KarpelesLab/ledger_implant_detector/hardware/detector/fab/drc_report.txt

** Drc report for implant_detector.kicad_pcb **
** Created on 2026-10-18T11:38:48 **
** Report includes: Errors, Warnings, Exclusions **

** Found 5 DRC violations **
[starved_thermal]: Thermal relief connection to zone incomplete (layer F.Cu; zone min spoke count 2; actual 1)
    Local override; error
    @(220.0000 mm, 80.0000 mm): Zone 'GND_top' [GND] on F.Cu, priority 0
    @(132.4375 mm, 100.2500 mm): Pad 4 [GND] of U1 on F.Cu
[starved_thermal]: Thermal relief connection to zone incomplete (layer F.Cu; zone min spoke count 2; actual 1)
    Local override; error
    @(220.0000 mm, 80.0000 mm): Zone 'GND_top' [GND] on F.Cu, priority 0
    @(215.1700 mm, 99.6800 mm): PTH pad SH [GND] of J1
[starved_thermal]: Thermal relief connection to zone incomplete (layer F.Cu; zone min spoke count 2; actual 1)
    Local override; error
    @(220.0000 mm, 80.0000 mm): Zone 'GND_top' [GND] on F.Cu, priority 0
    @(208.0000 mm, 92.2250 mm): Pad 2 [GND] of C11 on F.Cu
[silk_edge_clearance]: Silkscreen clipped by board edge
    Rule: board setup constraints silk; warning
    @(222.0000 mm, 82.0000 mm): Segment on Edge.Cuts
    @(220.3000 mm, 99.3000 mm): Segment of J1 on F.Silkscreen
[silk_edge_clearance]: Silkscreen clipped by board edge
    Rule: board setup constraints silk; warning
    @(222.0000 mm, 82.0000 mm): Segment on Edge.Cuts
    @(220.3000 mm, 108.7000 mm): Segment of J1 on F.Silkscreen

** Found 0 unconnected pads **

** Found 0 Footprint errors **

** Ignored checks **
    - Footprint has no courtyard defined
    - Track endpoint not centered on via
    - Tuning profile track geometries
    - Footprint doesn't match symbol's footprint filters
    - Footprint component type doesn't match footprint pads

** End of Report **
