KarpelesLab/ledger_implant_detector/hardware/fixtures/tem_plate/fab/drc_report.txt

** Drc report for tem_plate.kicad_pcb **
** Created on 2026-10-26T17:50:04 **
** Report includes: Errors, Warnings **

** Found 0 DRC violations **

** Found 0 unconnected pads **

** Found 0 Footprint errors **

** Ignored checks **
    - Footprint has no courtyard defined
    - Track endpoint not centered on via
    - Tuning profile track geometries
    - Footprint doesn't match symbol's footprint filters
    - Isolated copper fill
    - Footprint component type doesn't match footprint pads

** End of Report **
