KarpelesLab/ledger_implant_detector/data/rf/2026-10-18/img/tamp_antenna_feed.png

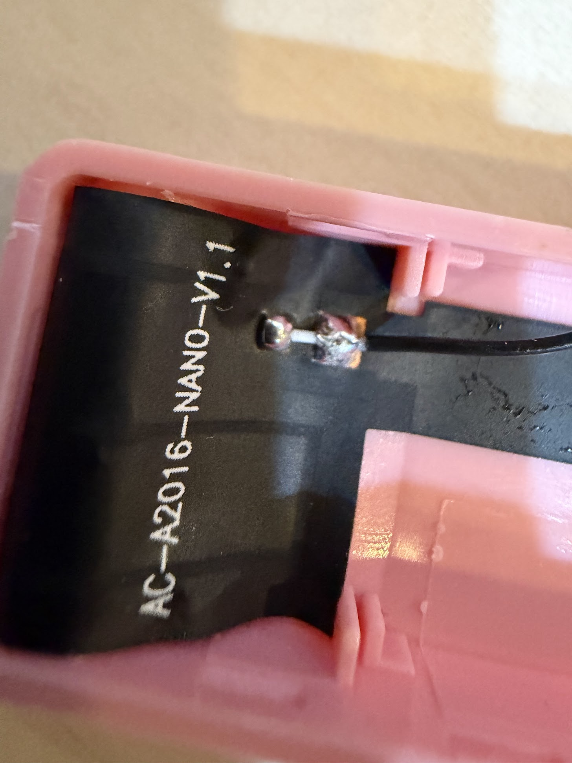
data/rf/2026-10-18/img/tamp_antenna_feed.png
