KarpelesLab/ledger_implant_detector/docs/img/fixture_carrier_bottom.png

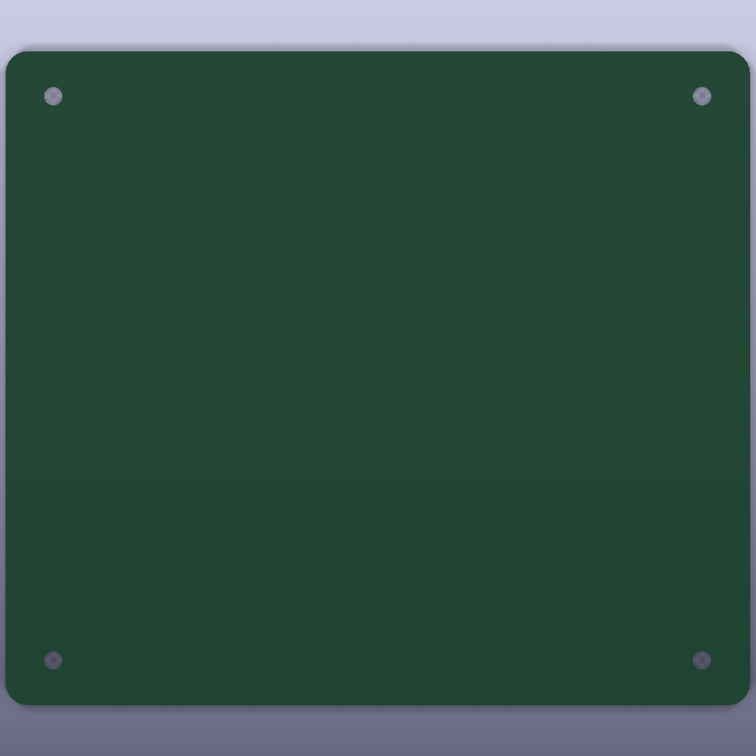
docs/img/fixture_carrier_bottom.png
