KarpelesLab/ledger_implant_detector/docs/img/fixture_slot_bottom.png

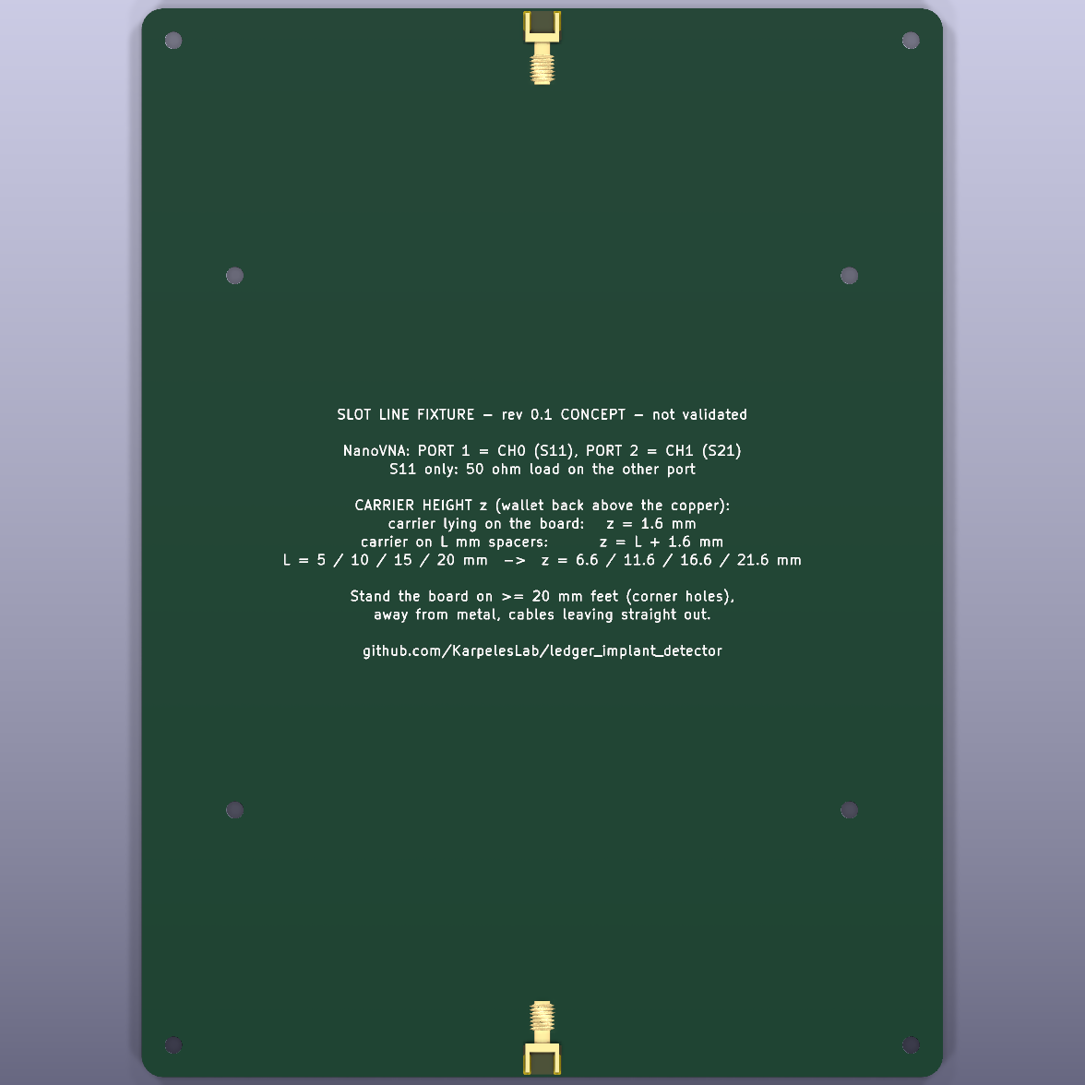
docs/img/fixture_slot_bottom.png
