KarpelesLab/ledger_implant_detector/docs/img/fixture_tem_base_bottom.png

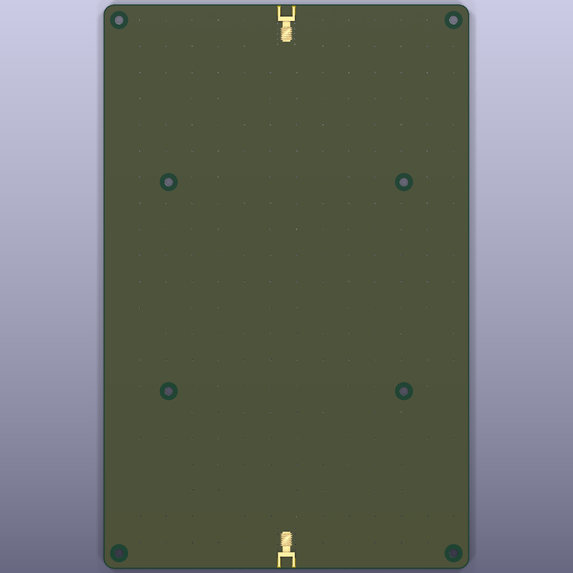
docs/img/fixture_tem_base_bottom.png
