KarpelesLab/ledger_implant_detector/docs/img/fixture_tem_ramp_bottom.png

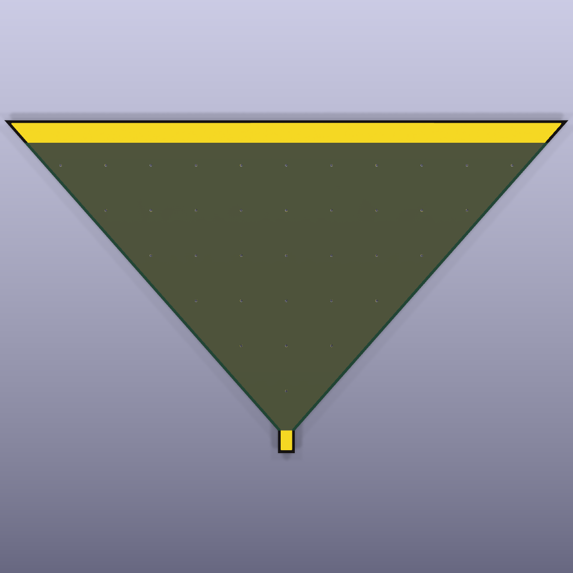
docs/img/fixture_tem_ramp_bottom.png
