KarpelesLab/ledger_implant_detector/hardware/detector/fab/bom.csv

Designator | Value | Footprint | MPN | Manufacturer | LCSC | Qty | DNP
BZ1 | PKLCS1212E4001 | Buzzer_Beeper:Buzzer_Murata_PKLCS1212E | PKLCS1212E4001-R1 | Murata |  | 1
C1-C8 | 33p | Capacitor_SMD:C_0603_1608Metric | GRM1885C1H330FA01D | Murata |  | 8
C9,C10,C13 | 4.7u | Capacitor_SMD:C_0603_1608Metric |  |  |  | 3
C11,C12,C14,C15,C17,C19 | 100n | Capacitor_SMD:C_0603_1608Metric |  |  |  | 6
C16,C18 | 1u | Capacitor_SMD:C_0603_1608Metric |  |  |  | 2
D1 | GREEN | LED_SMD:LED_0603_1608Metric | 19-217/GHC-YR1S2/3T | Everlight |  | 1
D2 | RED | LED_SMD:LED_0603_1608Metric | 19-217/R6C-AL1M2VY/3T | Everlight |  | 1
J1 | USB-C | Connector_USB:USB_C_Receptacle_HRO_TYPE-C-31-M-12 | TYPE-C-31-M-12 | Korean Hroparts Elec | C165948 | 1
J2 | Qwiic | Connector_JST:JST_SH_SM04B-SRSS-TB_1x04-1MP_P1.00mm_Horizontal | SM04B-SRSS-TB(LF)(SN) | JST |  | 1
J4 | SMA | Connector_Coaxial:SMA_Samtec_SMA-J-P-H-ST-EM1_EdgeMount | SMA-J-P-H-ST-EM1 | Samtec |  | 1
L1-L8 | 18u | Inductor_SMD:L_1210_3225Metric | CMH322522-180KL | Bourns |  | 8
R1,R2 | 5.1k | Resistor_SMD:R_0603_1608Metric |  |  |  | 2
R3,R9,R10 | 10k | Resistor_SMD:R_0603_1608Metric |  |  |  | 3
R4,R5 | 1k | Resistor_SMD:R_0603_1608Metric |  |  |  | 2
R6 | 100 | Resistor_SMD:R_0603_1608Metric |  |  |  | 1
R7,R8 | 4.7k | Resistor_SMD:R_0603_1608Metric |  |  |  | 2
R11 | 100k | Resistor_SMD:R_0603_1608Metric |  |  |  | 1
R12 | 33 | Resistor_SMD:R_0603_1608Metric |  |  |  | 1
SW1 | CAL | Button_Switch_SMD:SW_SPST_PTS810 | PTS810 SJM 250 SMTR LFS | C&K |  | 1
SW2 | BOOT | Button_Switch_SMD:SW_SPST_PTS810 | PTS810 SJM 250 SMTR LFS | C&K |  | 1
U1,U2 | FDC2214 | Package_DFN_QFN:WQFN-16-1EP_4x4mm_P0.5mm_EP2.6x2.6mm | FDC2214RGHR | Texas Instruments |  | 2
U3 | STM32F042F6P6 | Package_SO:TSSOP-20_4.4x6.5mm_P0.65mm | STM32F042F6P6 | STMicroelectronics |  | 1
U4 | AP2112K-3.3 | Package_TO_SOT_SMD:SOT-23-5 | AP2112K-3.3TRG1 | Diodes Inc |  | 1
U5 | USBLC6-2SC6 | Package_TO_SOT_SMD:SOT-23-6 | USBLC6-2SC6 | STMicroelectronics |  | 1
Y1 | 40MHz | Oscillator:Oscillator_SMD_Abracon_ASE-4Pin_3.2x2.5mm | ASE-40.000MHZ-LC-T | Abracon |  | 1
