KarpelesLab/ledger_implant_detector/hardware/detector/fab/schematic.pdf

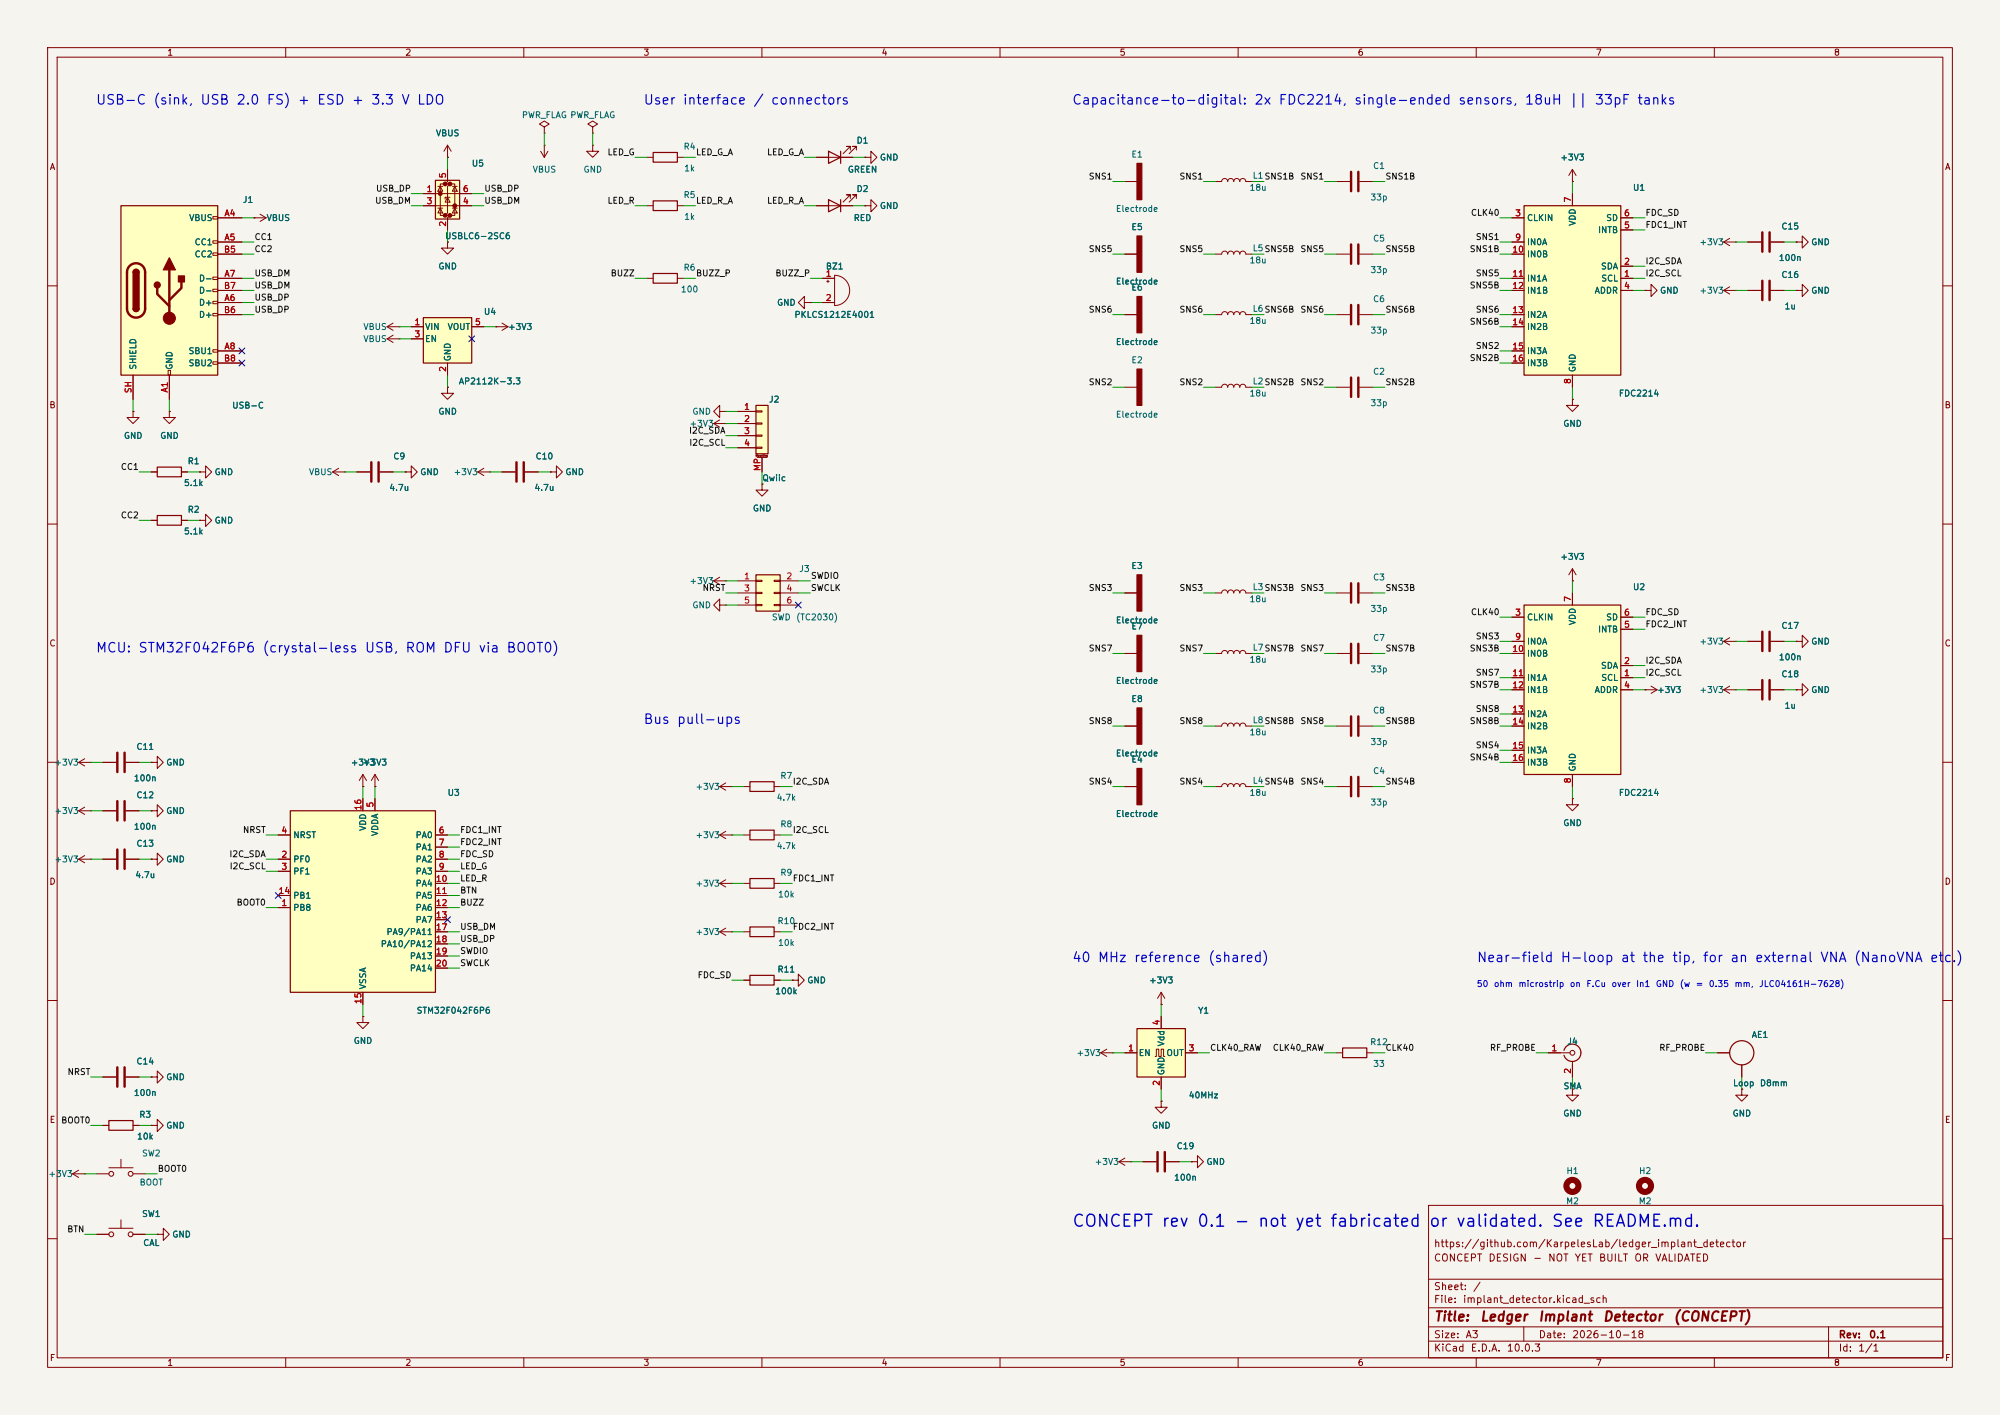
[picture p23: page 1]

USB-C (sink, USB 2.0 FS) + ESD + 3.3 V LDO

MCU: STM32F042F6P6 (crystal-less USB, ROM DFU via BOOT0)

Near-field H-loop at the tip, for an external VNA (NanoVNA etc.)

50 ohm microstrip on F.Cu over In1 GND (w = 0.35 mm, JLC04161H-7628)

https://github.com/KarpelesLab/ledger_implant_detector
CONCEPT DESIGN - NOT YET BUILT OR VALIDATED

Sheet: /
File: implant_detector.kicad_sch
Title: Ledger Implant Detector (CONCEPT)

Size: A3 | Rev: 0.1
KiCad E.D.A. 10.0.3 | Id: 1/1 | F Date: 2026-10-18
