KarpelesLab/ledger_implant_detector/hardware/detector/implant_detector.kicad_pcb

## KiCad design hardware/detector/implant_detector.kicad_pcb (2026-10-18)

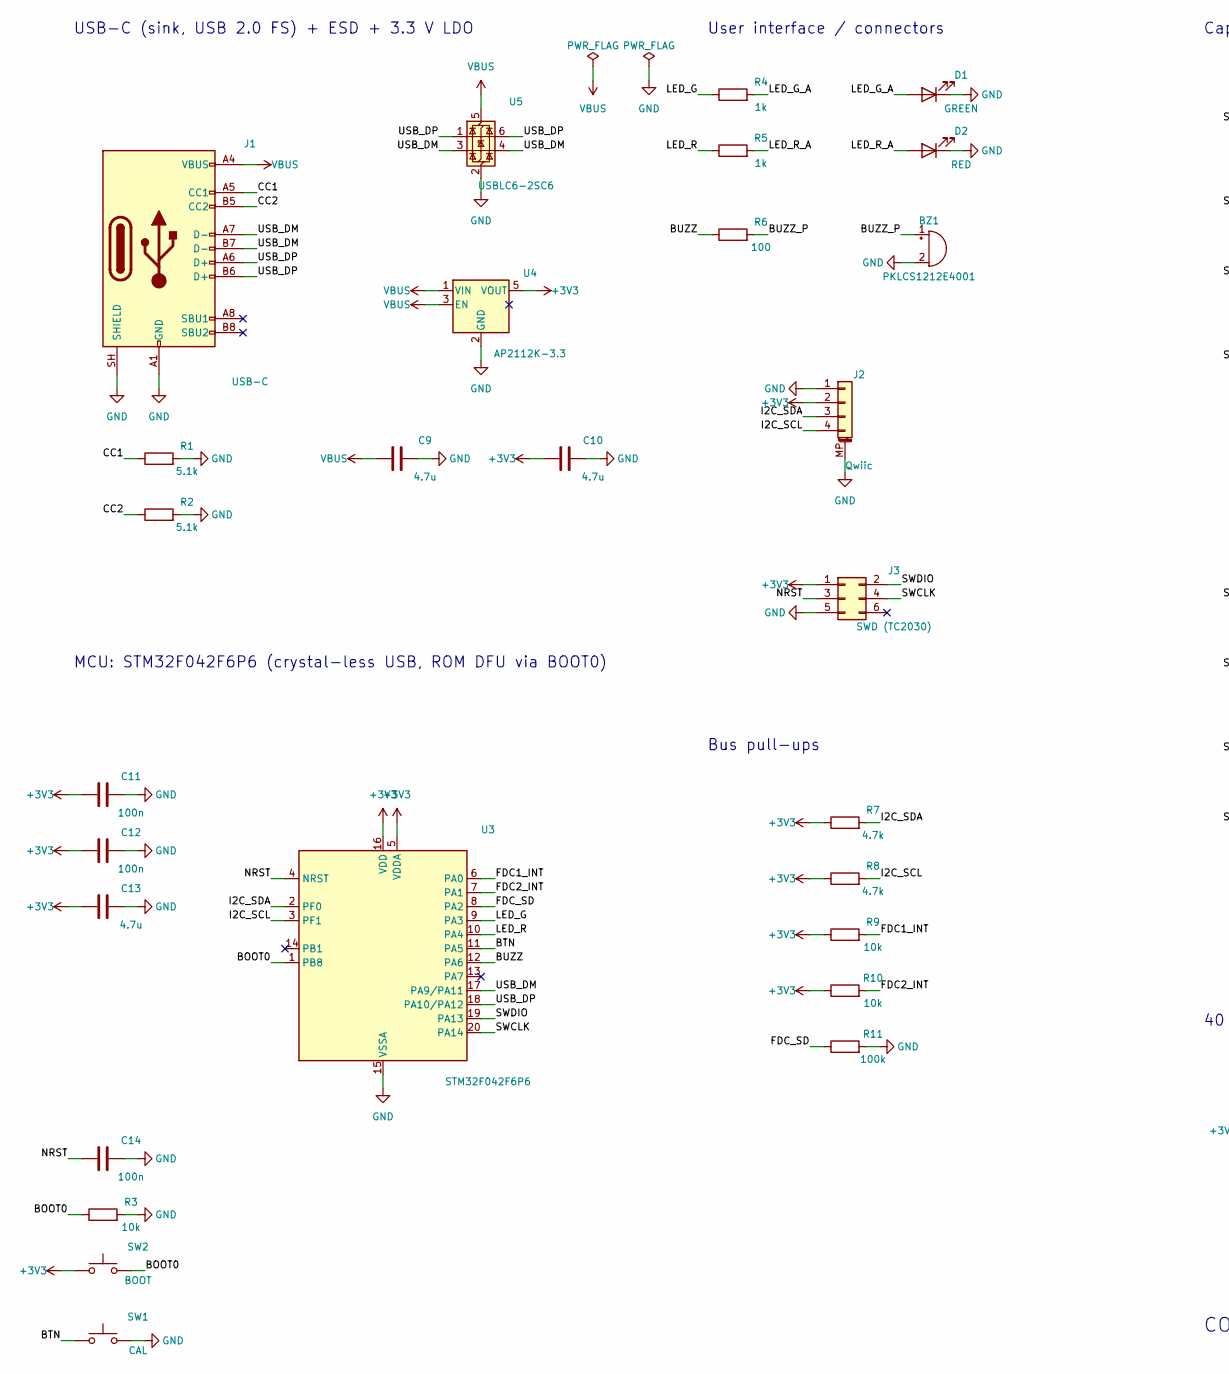
[picture p24: schematic implant_detector.kicad_sch, Ledger Implant Detector (CONCEPT), part in row 1, column 1]

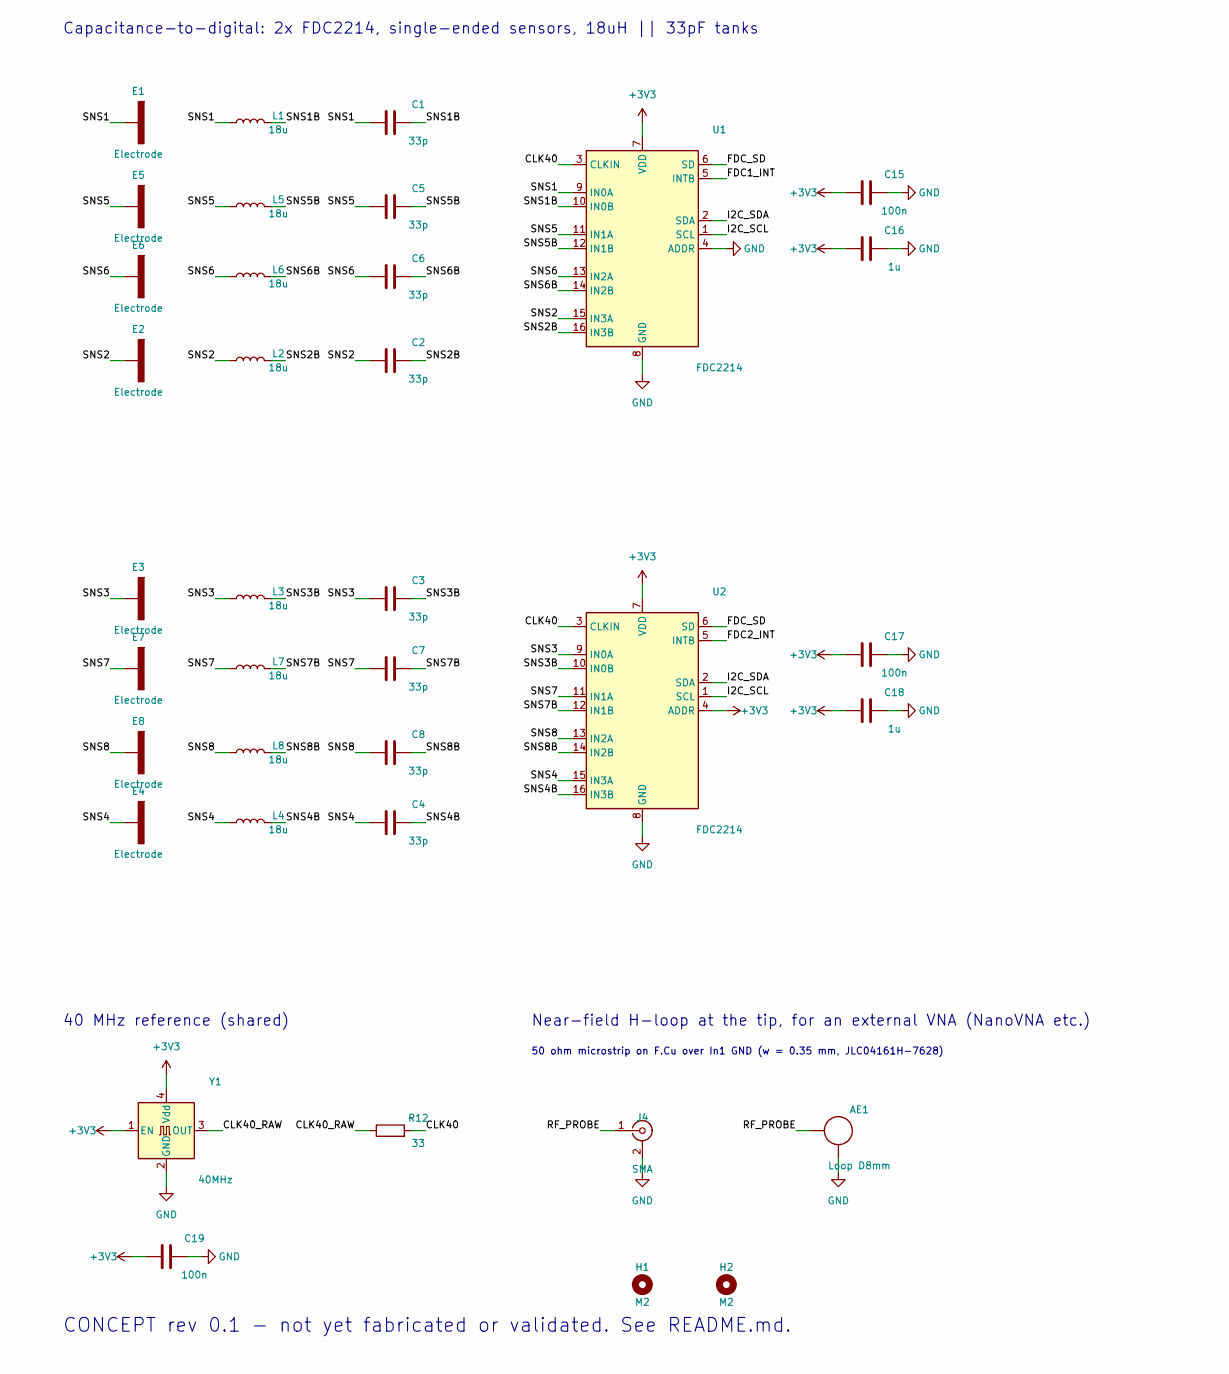
[picture p25: schematic implant_detector.kicad_sch, Ledger Implant Detector (CONCEPT), part in row 1, column 2]

Parts:
AE1: Loop D8mm; NearField_Loop_D8mm
BZ1: PKLCS1212E4001; Buzzer_Murata_PKLCS1212E; MPN PKLCS1212E4001-R1
C1, C2, C3, C4, C5, C6, C7, C8: 33p; C_0603_1608Metric; Tolerance 1%; MPN GRM1885C1H330FA01D
C9, C10, C13: 4.7u; C_0603_1608Metric; Voltage 10V
C11, C12, C14, C15, C17, C19: 100n; C_0603_1608Metric
C16, C18: 1u; C_0603_1608Metric
D1: GREEN; LED_0603_1608Metric; MPN 19-217/GHC-YR1S2/3T
D2: RED; LED_0603_1608Metric; MPN 19-217/R6C-AL1M2VY/3T
E1, E2, E3, E4, E5, E6, E7, E8: Electrode; Electrode_14x14mm
H1, H2: M2; MountingHole_2.2mm_M2
J1: USB-C; USB_C_Receptacle_HRO_TYPE-C-31-M-12; MPN TYPE-C-31-M-12; LCSC C165948
J2: Qwiic; JST_SH_SM04B-SRSS-TB_1x04-1MP_P1.00mm_Horizontal; MPN SM04B-SRSS-TB(LF)(SN)
J3: SWD (TC2030); Tag-Connect_TC2030-IDC-NL_2x03_P1.27mm_Vertical
J4: SMA; SMA_Samtec_SMA-J-P-H-ST-EM1_EdgeMount; MPN SMA-J-P-H-ST-EM1
L1, L2, L3, L4, L5, L6, L7, L8: 18u; L_1210_3225Metric; MPN CMH322522-180KL
R1, R2: 5.1k; R_0603_1608Metric
R3, R9, R10: 10k; R_0603_1608Metric
R4, R5: 1k; R_0603_1608Metric
R6: 100; R_0603_1608Metric
R7, R8: 4.7k; R_0603_1608Metric
R11: 100k; R_0603_1608Metric
R12: 33; R_0603_1608Metric
SW1: CAL; SW_SPST_PTS810; MPN PTS810 SJM 250 SMTR LFS
SW2: BOOT; SW_SPST_PTS810; MPN PTS810 SJM 250 SMTR LFS
U1, U2: FDC2214; WQFN-16-1EP_4x4mm_P0.5mm_EP2.6x2.6mm; MPN FDC2214RGHR
U3: STM32F042F6P6; TSSOP-20_4.4x6.5mm_P0.65mm; MPN STM32F042F6P6
U4: AP2112K-3.3; SOT-23-5; MPN AP2112K-3.3TRG1
U5: USBLC6-2SC6; SOT-23-6; MPN USBLC6-2SC6
Y1: 40MHz; Oscillator_SMD_Abracon_ASE-4Pin_3.2x2.5mm; MPN ASE-40.000MHZ-LC-T

Connections:
+3V3: C10.1, C11.1, C12.1, C13.1, C15.1, C16.1, C17.1, C18.1, C19.1, J2.2, J3.1, R7.1, R8.1, R9.1, R10.1, SW2.1, U1.7 (VDD), U2.4 (ADDR), U2.7 (VDD), U3.5 (VDDA), U3.16 (VDD), U4.5 (VOUT), Y1.1 (EN), Y1.4 (Vdd)
/BOOT0: R3.1, SW2.2, U3.1 (PB8)
/BTN: SW1.1, U3.11 (PA5)
/BUZZ: R6.1, U3.12 (PA6)
/BUZZ_P: BZ1.1 (+), R6.2
/CC1: J1.A5 (CC1), R1.1
/CC2: J1.B5 (CC2), R2.1
/CLK40: R12.2, U1.3 (CLKIN), U2.3 (CLKIN)
/CLK40_RAW: R12.1, Y1.3 (OUT)
/FDC1_INT: R9.2, U1.5 (INTB), U3.6 (PA0)
/FDC2_INT: R10.2, U2.5 (INTB), U3.7 (PA1)
/FDC_SD: R11.1, U1.6 (SD), U2.6 (SD), U3.8 (PA2)
/I2C_SCL: J2.4, R8.2, U1.1 (SCL), U2.1 (SCL), U3.3 (PF1)
/I2C_SDA: J2.3, R7.2, U1.2 (SDA), U2.2 (SDA), U3.2 (PF0)
/LED_G: R4.1, U3.9 (PA3)
/LED_G_A: D1.2 (A), R4.2
/LED_R: R5.1, U3.10 (PA4)
/LED_R_A: D2.2 (A), R5.2
/NRST: C14.1, J3.3, U3.4 (NRST)
/RF_PROBE: AE1.1 (FEED), J4.1 (In)
/SNS1: C1.1, E1.1, L1.1, U1.9 (IN0A)
/SNS1B: C1.2, L1.2, U1.10 (IN0B)
/SNS2: C2.1, E2.1, L2.1, U1.15 (IN3A)
/SNS2B: C2.2, L2.2, U1.16 (IN3B)
/SNS3: C3.1, E3.1, L3.1, U2.9 (IN0A)
/SNS3B: C3.2, L3.2, U2.10 (IN0B)
/SNS4: C4.1, E4.1, L4.1, U2.15 (IN3A)
/SNS4B: C4.2, L4.2, U2.16 (IN3B)
/SNS5: C5.1, E5.1, L5.1, U1.11 (IN1A)
/SNS5B: C5.2, L5.2, U1.12 (IN1B)
/SNS6: C6.1, E6.1, L6.1, U1.13 (IN2A)
/SNS6B: C6.2, L6.2, U1.14 (IN2B)
/SNS7: C7.1, E7.1, L7.1, U2.11 (IN1A)
/SNS7B: C7.2, L7.2, U2.12 (IN1B)
/SNS8: C8.1, E8.1, L8.1, U2.13 (IN2A)
/SNS8B: C8.2, L8.2, U2.14 (IN2B)
/SWCLK: J3.4, U3.20 (PA14)
/SWDIO: J3.2, U3.19 (PA13)
/USB_DM: J1.A7 (D-), J1.B7 (D-), U3.17 (PA9/PA11), U5.3 (I/O2), U5.4 (I/O2)
/USB_DP: J1.A6 (D+), J1.B6 (D+), U3.18 (PA10/PA12), U5.1 (I/O1), U5.6 (I/O1)

Notes on the sheet:
USB-C (sink, USB 2.0 FS) + ESD + 3.3 V LDO
MCU: STM32F042F6P6 (crystal-less USB, ROM DFU via BOOT0)
User interface / connectors
Bus pull-ups
40 MHz reference (shared)
Capacitance-to-digital: 2x FDC2214, single-ended sensors, 18uH || 33pF tanks
Near-field H-loop at the tip, for an external VNA (NanoVNA etc.)
50 ohm microstrip on F.Cu over In1 GND (w = 0.35 mm, JLC04161H-7628)
CONCEPT rev 0.1 - not yet fabricated or validated. See README.md.

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
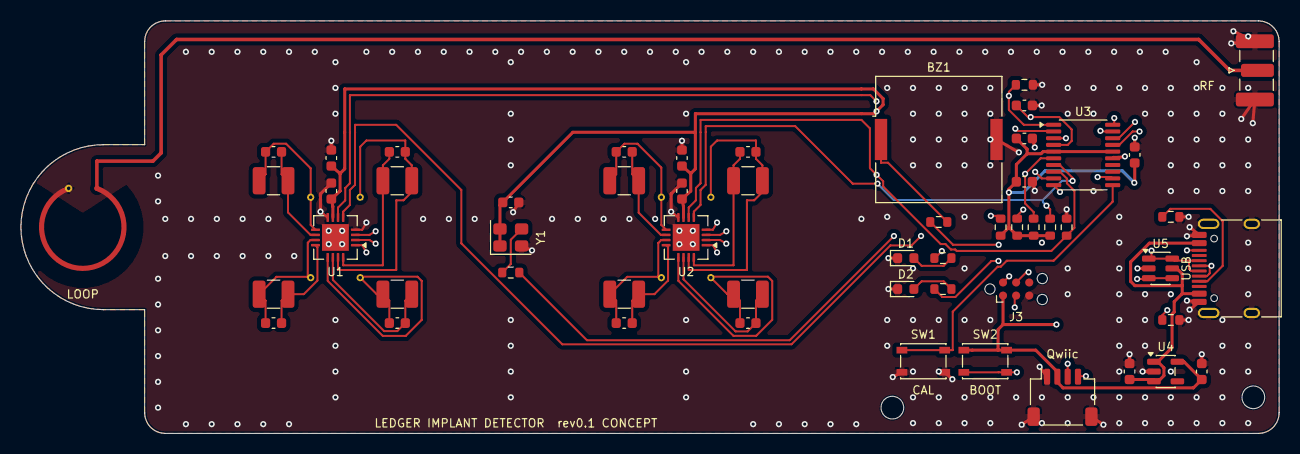
[picture p26: board implant_detector.kicad_pcb from above]

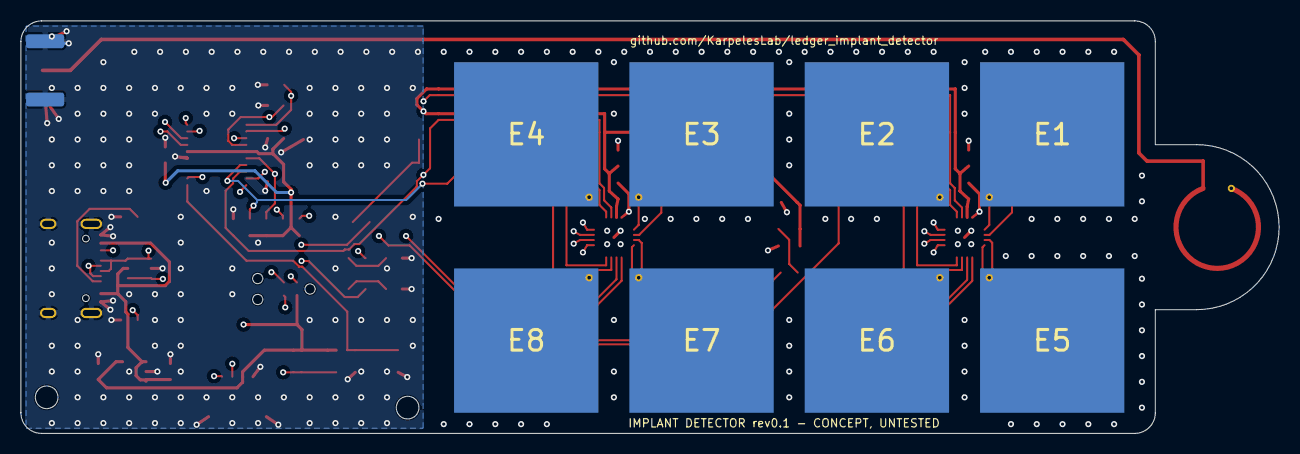
[picture p27: board implant_detector.kicad_pcb from below]

Board: 4 copper layers, 122.0 x 40.0 mm, 65 parts (8 on the bottom side), 42 nets.
