KarpelesLab/ledger_implant_detector/hardware/fixtures/slot/slot.kicad_pcb

## KiCad design hardware/fixtures/slot/slot.kicad_pcb (2026-10-18)

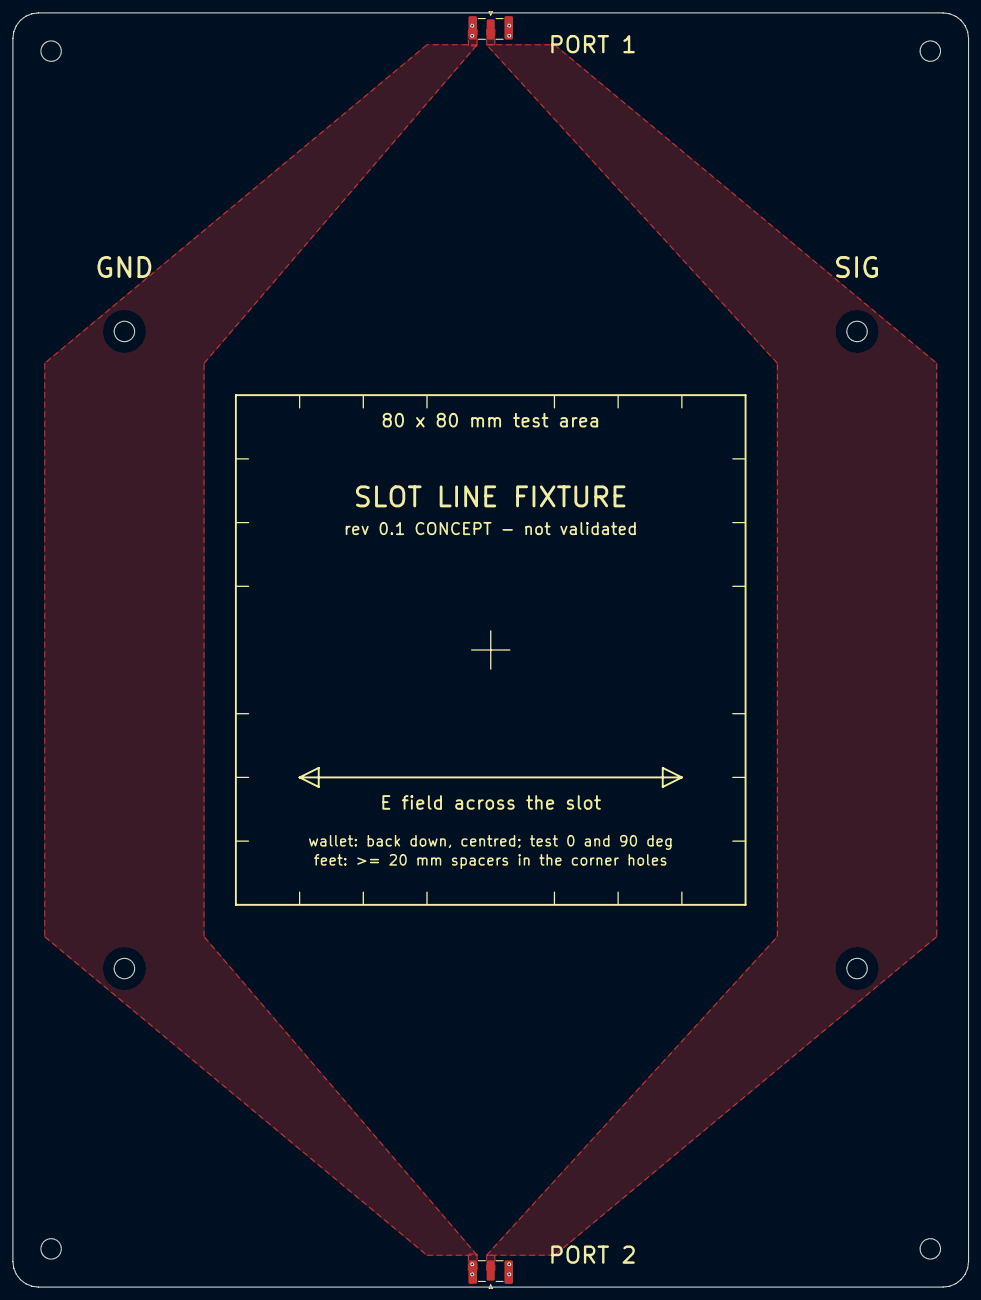
[picture p28: board slot.kicad_pcb from above]

Board: 2 copper layers, 150.0 x 200.0 mm, 10 parts (0 on the bottom side), 2 nets, no tracks yet.

Parts:
H1, H2, H3, H4, H5, H6, H7, H8: MountingHole_3.2mm_M3
J1, J2: SMA edge jack (Samtec SMA-J-P-H-ST-EM1); SMA_Samtec_SMA-J-P-H-ST-EM1_EdgeMount

Connections:
GND: J1.2, J2.2
SIG: J1.1, J2.1
