KarpelesLab/ledger_implant_detector/(commit log)

2026-10-18 Add concept README for capacitive Ledger implant detector
2026-10-18 Add project library and detector schematic (ERC clean)
    FDC2214 symbol derived from KiCad LDC1314 (pin-compatible WQFN-16),
    electrode and near-field loop footprints, schematic generator.
    [implant_detector.kicad_sch]
2026-10-18 Add routed 4-layer detector PCB, fab outputs and renders
    Single board: 8-electrode capacitive head (2x FDC2214), STM32F042 with USB-C
    power + ROM DFU programming, near-field RF loop at the tip with edge SMA.
    Electrodes shrunk to 14x14 mm to open a via channel; head tanks and escapes
    are pre-routed deterministically, rest autorouted with Freerouting 1.9.
    DRC: 0 errors, 0 unconnected, schematic parity OK. ERC: 0 violations.
    Concept / untested, see README.
    [bom.csv, bom_jlc.csv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]
2026-10-18 Add NanoVNA measurement protocol and S11 comparison script
    Defines how to capture reference / mock-implant / copper-control sweeps so the
    data decides the on-board RF front end for rev 0.2 (scalar log detector vs
    gain/phase vs full VNA). analyze_s1p.py compares groups of Touchstone files
    against placement repeatability and prints that verdict.
2026-10-18 Add electrostatic + FDTD simulations of the implant antenna vs. the battery
    Electrostatic model of the detector over a genuine / tampered wallet with the
    antenna sandwiched between shell and battery: copper outside the battery's
    shadow is detectable well above placement errors; copper fully hidden behind
    the battery and floating is not. FDTD model of the RF loop (validated against
    cavity / capacitor / loop inductance); RF results to follow.
2026-10-18 Clarify antenna/battery geometry wording in the simulation write-up
    The antenna is always between the shell and the battery; the distinction that
    matters is how much of it extends beyond the battery's outline.
2026-10-18 Add RF FDTD results: loaded antenna shows an in-band absorption dip plain copper lacks
    Over the feed patch the tampered unit shows a ~0.35 dB, ~100 MHz wide dip at
    ~1.8 GHz that neither the genuine unit nor a plain-copper control of the same
    outline has; copper lying on the battery foil is RF-dead. Simulated .s1p
    files included for comparison with NanoVNA measurements.
2026-10-18 Add NanoVNA capture tool and first RF session on a real implanted Nano X
    tools/nanovna_capture.py drives a NanoVNA-F V2 text shell: OSLT calibration
    steps, 401-point captures from interleaved 201-point scans with averaging,
    retry on the firmware's all-zeros state, and .s1p or .s2p (S11 + S21) output.
    analyze_s1p.py gains --s21 to compare transmission sweeps.
    data/rf/2026-10-18: genuine Nano X vs a real modified unit (custom FPC LTE
    antenna "AC-A2016-NANO-V1.1", photo included). Reflection (S11) with a bare
    coax tip and a 5 mm H loop shows no separation above placement spread.
    Transmission from a ~10 mm H loop to a GSM antenna does: the tampered unit
    re-radiates at ~820-850 MHz, 740-860 MHz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
2026-10-18 Add position-independent RF test fixture kit (concept): slot line, open TEM cell, carrier
    Five 2-layer boards with SMA edge jacks for NanoVNA S11/S21 tests over an
    80 x 80 mm area, generated by tools/gen_fixtures.py (DRC clean apart from
    SMA footprint silk at the board edge). FDTD gains a terminated second port
    (S21) and lumped inductors; sim/fixtures_fdtd.py models both fixtures with a
    genuine and a tampered (835 MHz antenna) wallet. Simulation results pending.
    [carrier-B_Cu.gbl, carrier-B_Mask.gbs, carrier-B_Silkscreen.gbo, carrier-Edge_Cuts.gm1, carrier-F_Cu.gtl, carrier-F_Mask.gts, carrier-F_Silkscreen.gto, carrier-NPTH.drl]
2026-10-19 Add JLCPCB order sheet and BOM for the RF fixture kit
    [bom.csv]
2026-10-19 Fixture simulations: slot line and TEM cell both see the implant at every placement
    32 FDTD runs (empty, genuine, tampered; two placements per orientation).
    Slot line at 0 deg: ~0.5 dB, 20 MHz wide notch at 815-835 MHz, blind at
    90 deg. TEM cell, wallet flat: 1-6 dB notch near 1.2 GHz from the implant's
    3D parts, genuine placement spread 0.01-0.03 dB. Wallet on edge: nothing.
2026-10-19 Model a second implant variant: hand-wound spiral antenna (Joe Grand's Nano X implant)
    8 cm of ~0.3 mm wire, ~6 uneven turns, ~6 mm across, half over the implant
    board's edge, modem-fed; battery shortened 44 -> 26 mm. FDTD: square spiral
    on a local 0.25 mm grid with a turn-coupling slab, 'grand' and 'gref' cases
    in every fixture placement, tune-grand for the free-space resonance.
    Electrostatic: shortened battery + implant board + spiral, floating or tied.
2026-10-19 Capacitive array sees the spiral implant's shortened battery: 1.3-3.4 pF above placement error
2026-10-20 Spiral implant: tune resonance vs. turn coupling and height over the board (795-865 MHz at eps 1)
2026-10-20 Spiral implant in the fixtures: not seen in the LTE low band (< 0.02 dB); capacitive array covers it
    14 placements + 3 grid checks (< 0.02 dB). The 6 mm coil over its own board's
    ground hardly links to an 80 x 80 mm uniform field. Its only narrow feature
    (~2.18 GHz in the TEM cell) sits where a moved genuine wallet also gives up
    to 1.5 dB. Docs and README: run the capacitive scan as well; a clean fixture
    result does not rule out a compact coil antenna.
2026-10-26 First fixture session: TEM cell sees the implant at every placement
    TEM cell (h = 20 mm): the implanted Nano X shows a ~1 dB, ~40 MHz wide
    notch at 1171 MHz at every placement and both orientations (sim: -1.2 dB
    at 1185 MHz). Six of seven genuine placements stay within 0.2 dB; one
    genuine re-check showed a similar notch near 1230 MHz, cause unknown.
    Slot line: a small (-0.13..-0.20 dB) dip at 817-861 MHz at 0 deg only.
    Also:
    - gen_fixtures.py: TEM landing marks now place the ramp tip where the
    rigid ramp's tab actually lands, with the ramp overlapping the septum by
    4 mm; regenerated TEM boards and assembly step 3.
    - nanovna_capture.py: zeros mean "outside the active calibration's span"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
    [tem_base-B_Cu.gbl, tem_base-B_Mask.gbs, tem_base-B_Silkscreen.gbo, tem_base-Edge_Cuts.gm1, tem_base-F_Cu.gtl, tem_base-F_Mask.gts, tem_base-F_Silkscreen.gto, tem_base-NPTH.drl]
2026-10-26 Write up the first fixture measurements in docs/fixtures.md and the README
    TEM cell h = 20: 1171 MHz notch on 12/12 tampered captures (sim -1.2 dB
    at 1185 MHz), 18/19 genuine within 0.22 dB, one unexplained genuine
    outlier. Slot line: ~0.15 dB at 0 deg only. Also note the NanoVNA
    'recall 0' pitfall in the procedure.
2026-10-31 Add crossed-loop fixture simulation (two large H-field loops at 90 degrees)
    - rf_fdtd: lumped capacitor element (checked against 1/(jwC) on a small loop).
    - xloop_fdtd: segmented loops with C + R in every gap. Configurations:
    xv (two vertical loops, crossed), hv (horizontal loop under + vertical
    loop), cx (wallet-sized coaxial pair, wallet in a jig). Ports sit on the
    other loop's mirror plane, so the empty crossed loops cancel (-80 dB).
    - fixtures_fdtd: flat180 orientation (wallet turned end for end).
    - report: `report.py xloop` figure and table, with a narrow-peak measure
    (|S21| minus its running median) since the genuine wallet's own S21
    level moves ~45 dB with placement.
    - Resul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
2026-10-31 Crossed and coaxial loop fixtures: results and write-up
    All runs done (xv, hv at 10 and 50 ohm per gap; cx coaxial pair at both).
    docs/fixtures.md gains a section and docs/img/sim_xloop.png.
    - Crossed vertical loops (xv, 10 ohm): narrow S21 peak at 825-840 MHz at all
    four placements, 10-13 dB above its running median, but only at -57..-70 dB
    absolute. A genuine wallet moved 28 mm raises S21 by ~45 dB, so the test has
    to look for a narrow peak, not a level.
    - Horizontal + vertical (hv): misses the resonance when centred.
    - Coaxial wallet-sized pair (cx): nothing in the LTE low band; a +-2.5 dB
    swing near 1.1-1.2 GHz that drops below 1 dB with the wallet end for end.
    - 50 ohm damping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
